suefro/openWM/README.md

# openWM
open-source programmer for washing machine
