suefro/openWM/PCB/WM_TriacSwitchModuleRev4.brd

## EAGLE design PCB/WM_TriacSwitchModuleRev4.brd (2017-04-11)

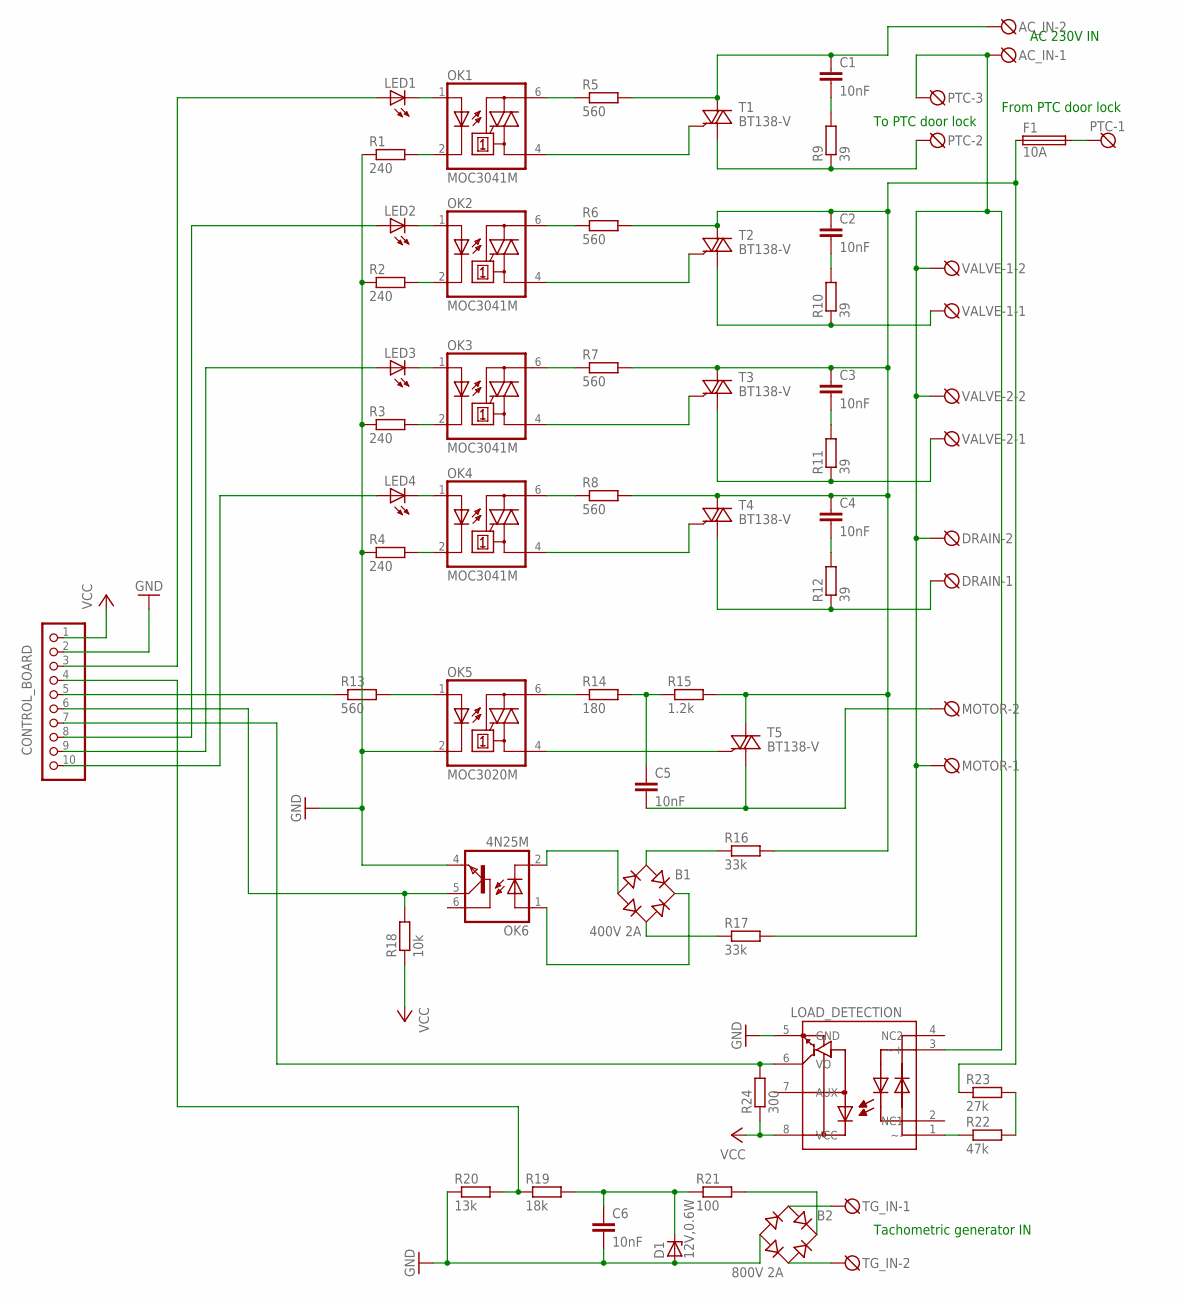
[picture p1: schematic WM_TriacSwitchModuleRev4.sch]

Parts:
AC_IN: N L; DG306-5.0-02P
B1: 400V 2A; RB1A
B2: 800V 2A; RB1A
C1, C2, C3, C4, C5: 10nF; C150-054X183
C6: 10nF; C050-024X044
CONTROL_BOARD: PINHD-1X10; 1X10-BIG
D1: 12V,0.6W; DO35Z10
DRAIN: L N; DG306-5.0-02P
F1: 10A; SH22,5
LED1, LED2, LED3, LED4: LEDCHIPLED_1206; CHIPLED_1206
LOAD_DETECTION: MID400; DIL08
MOTOR: N L; DG306-5.0-02P
OK1, OK2, OK3, OK4: MOC3041M; DIL06
OK5: MOC3020M; DIL06
OK6: 4N25M; DIL06
PTC: L_IN L_OUT N_OUT; DG306-5.0-03P
R1, R2, R3, R4: 240; 0207/10
R5, R6, R7, R8, R13: 560; 0207/10
R9, R10, R11, R12: 39; 0207/10
R14: 180; 0207/10
R15: 1.2k; 0207/10
R16, R17: 33k; 0207/10
R18: 10k; 0207/10
R19: 18k; 0207/10
R20: 13k; 0207/10
R21: 100; 0207/10
R22: 47k; 0207/15
R23: 27k; 0207/15
R24: 300; 0207/10
T1, T2, T3, T4, T5: BT138-V; TO220BV
TG_IN: DG3XX-02-5.0; DG306-5.0-02P
VALVE-1, VALVE-2: L N; DG306-5.0-02P

Connections:
GND: B2.-, C6.2, CONTROL_BOARD.2, D1.A, LOAD_DETECTION.5 (GND), OK5.2 (C), OK6.4 (EMI), R1.1, R2.1, R3.1, R4.1, R20.1
unnamed: LED1.C, OK1.1 (A)
unnamed: LED2.C, OK2.1 (A)
unnamed: LED3.C, OK3.1 (A)
unnamed: LED4.C, OK4.1 (A)
unnamed: OK1.2 (C), R1.2
unnamed: OK2.2 (C), R2.2
unnamed: OK3.2 (C), R3.2
unnamed: OK4.2 (C), R4.2
unnamed: AC_IN.1, DRAIN.2, LOAD_DETECTION.3 (~+), MOTOR.1, PTC.3, R17.2, VALVE-1.2, VALVE-2.2
unnamed: OK1.6 (A2), R5.1
unnamed: OK2.6 (A2), R6.1
unnamed: OK3.6 (A2), R7.1
unnamed: OK4.6 (A2), R8.1
unnamed: F1.2, PTC.1
unnamed: B1.-, OK6.2 (C)
unnamed: B1.AC1, R16.1
unnamed: OK3.4 (A1), T3.G
unnamed: OK4.4 (A1), T4.G
unnamed: OK2.4 (A1), T2.G
unnamed: OK1.4 (A1), T1.G
unnamed: PTC.2, R9.1, T1.T1 (A1)
unnamed: R10.1, T2.T1 (A1), VALVE-1.1
unnamed: R11.1, T3.T1 (A1), VALVE-2.1
unnamed: DRAIN.1, R12.1, T4.T1 (A1)
unnamed: C1.2, R9.2
unnamed: C2.2, R10.2
unnamed: C3.2, R11.2
unnamed: C4.2, R12.2
unnamed: OK5.1 (A), R13.2
unnamed: OK5.6 (A2), R14.1
unnamed: C5.1, R14.2, R15.1
unnamed: CONTROL_BOARD.6, OK6.5 (COL), R18.2
unnamed: OK5.4 (A1), T5.G
unnamed: B1.AC2, R17.1
unnamed: C2.1, C3.1, C4.1, F1.1, R6.2, R7.2, R8.2, R15.2, R16.2, R23.1, T2.T2 (A2), T3.T2 (A2), T4.T2 (A2), T5.T2 (A2)
unnamed: B2.AC1, TG_IN.1
unnamed: B1.+, OK6.1 (A)
unnamed: B2.AC2, TG_IN.2
unnamed: B2.+, R21.2
unnamed: C6.1, D1.C, R19.2, R21.1
unnamed: LOAD_DETECTION.1 (~-), R22.1
unnamed: AC_IN.2, C1.1, R5.2, T1.T2 (A2)
unnamed: R22.2, R23.2
unnamed: CONTROL_BOARD.3, LED1.A
unnamed: CONTROL_BOARD.7, LOAD_DETECTION.6 (VO), R24.2
unnamed: CONTROL_BOARD.4, R19.1, R20.2
unnamed: CONTROL_BOARD.5, R13.1
unnamed: CONTROL_BOARD.8, LED2.A
unnamed: CONTROL_BOARD.9, LED3.A
unnamed: CONTROL_BOARD.10, LED4.A
unnamed: C5.2, MOTOR.2, T5.T1 (A1)
VCC: CONTROL_BOARD.1, LOAD_DETECTION.8 (VCC), R18.1, R24.1

Notes on the sheet:
AC 230V IN
To PTC door lock
From PTC door lock
Tachometric generator IN

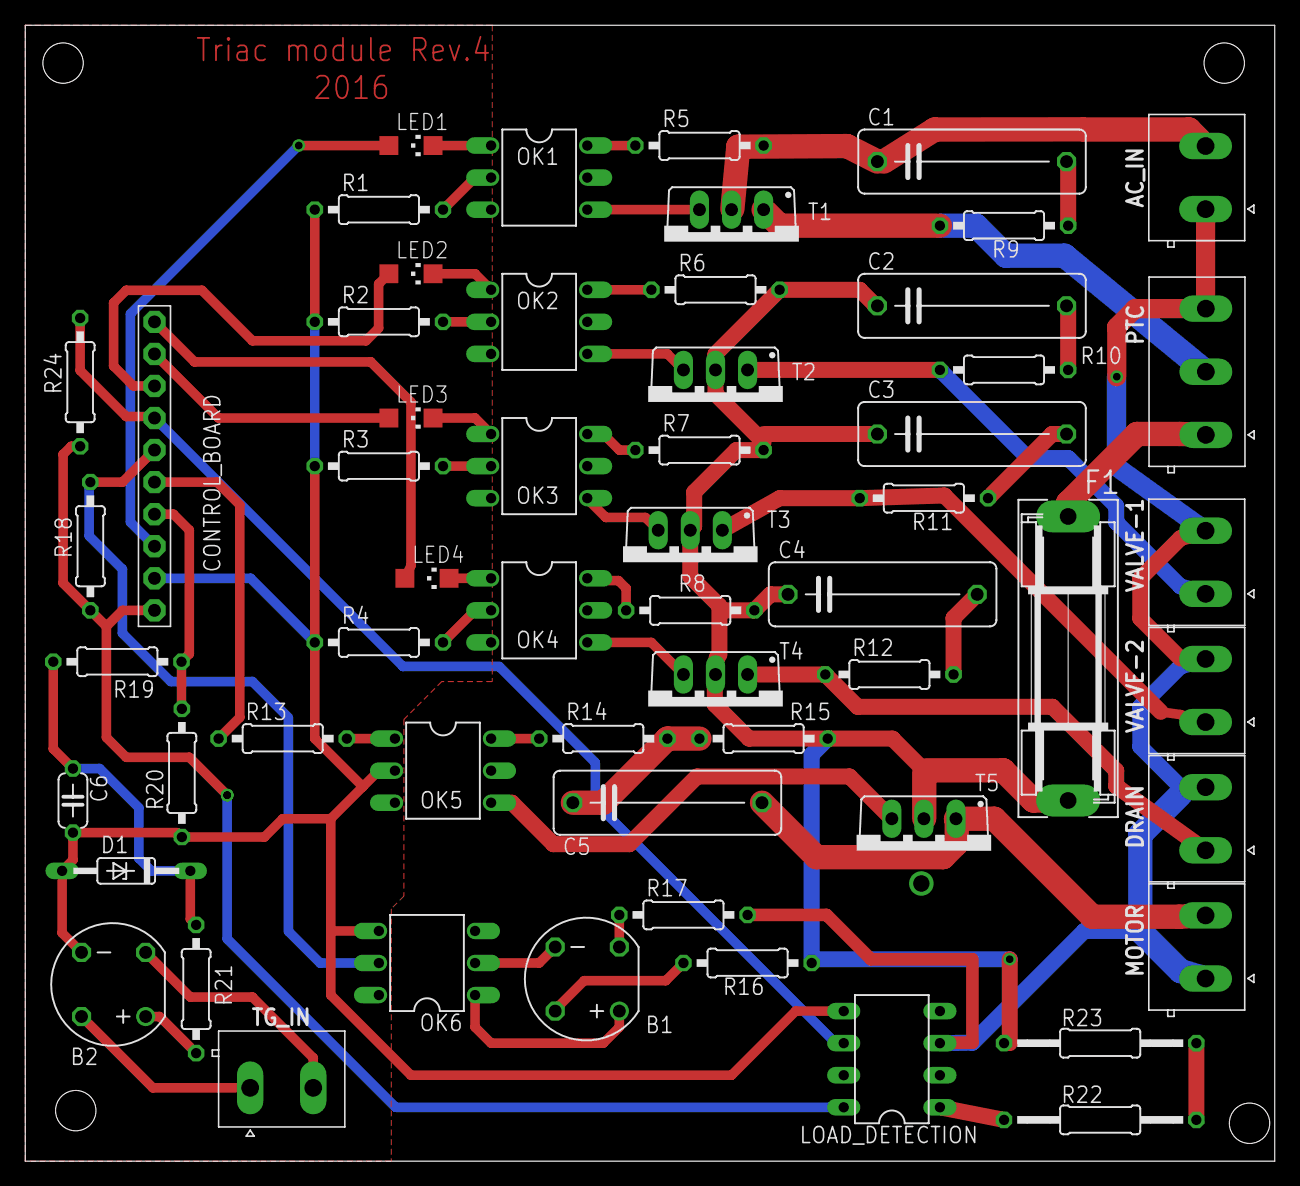
[picture p2: board WM_TriacSwitchModuleRev4.brd from above]

Board: 2 copper layers, 99.0 x 90.0 mm, 58 parts (0 on the bottom side), 53 nets.
