suefro/openWM/PCB/WM-main board1finalRev5_1.brd

## EAGLE design PCB/WM-main board1finalRev5_1.brd (2017-04-11)

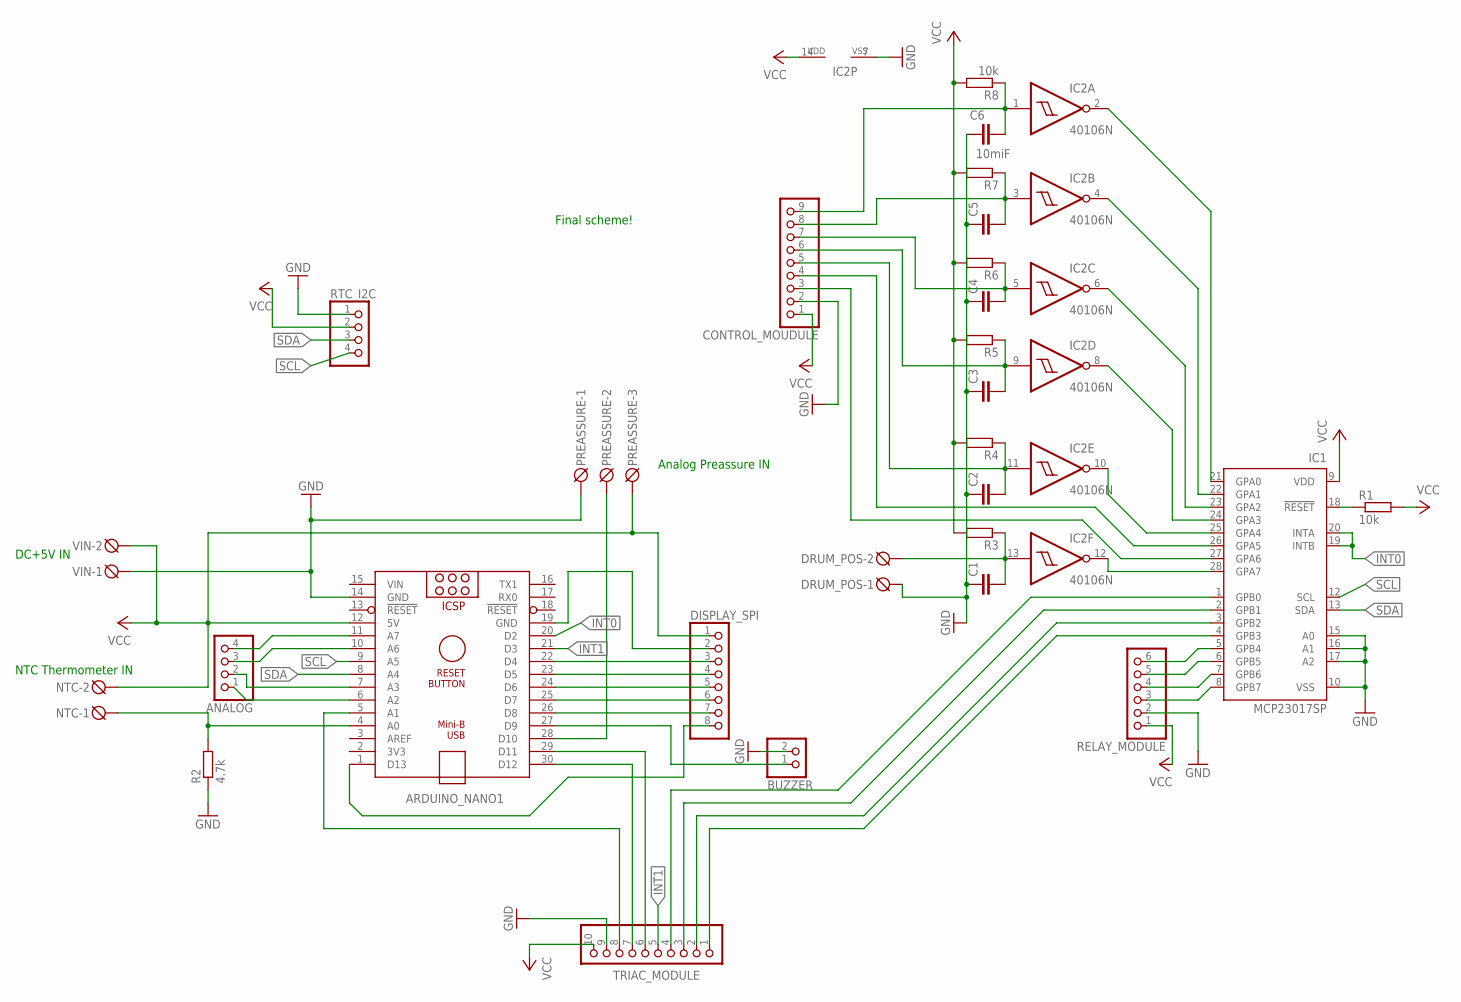
[picture p3: schematic WM-main board1finalRev5_1.sch]

Parts:
ANALOG: PINHD-1X4; 1X04
ARDUINO_NANO1: ARDUINO_NANO
BUZZER: PINHD-1X2; 1X02
C1, C2, C3, C4, C5: CC1206; C1206
C6: 10miF; C1206
CONTROL_MOUDULE: PINHD-1X9; 1X09-BIG
DISPLAY_SPI: PINHD-1X8BIG; 1X08-BIG
DRUM_POS: DRUM; DG306-5.0-02P
IC1: MCP23017SP; DIL28-3
IC2: 40106N; DIL14
NTC: TEMP; DG306-5.0-02P
PREASSURE: GND D10 +5V(out); DG306-5.0-03P
R1: 10k; 0204/7
R2: 4.7k; 0204/7
R3, R4, R5, R6, R7: R-EU_M1206; M1206
R8: 10k; M1206
RELAY_MODULE: PINHD-1X6B; 1X06-BIG
RTC_I2C: PINHD-1X4; 1X04
TRIAC_MODULE: PINHD-1X10; 1X10-BIG
VIN: GND +5V(IN); DG306-5.0-02P

Connections:
GND: ARDUINO_NANO1.14 (GND), BUZZER.2, C1.1, C2.1, C3.1, C4.1, C5.1, C6.1, CONTROL_MOUDULE.2, DRUM_POS.1, IC1.10 (VSS), IC1.15 (A0), IC1.16 (A1), IC1.17 (A2), IC2.7 (VSS), PREASSURE.1, R2.1, RELAY_MODULE.2, RTC_I2C.1, TRIAC_MODULE.9, VIN.1
INT0: ARDUINO_NANO1.20 (D2), IC1.19 (INTB), IC1.20 (INTA)
INT1: ARDUINO_NANO1.21 (D3), TRIAC_MODULE.5
unnamed: IC1.18 (!RESET), R1.1
unnamed: ARDUINO_NANO1.4 (A0), NTC.1, R2.2
unnamed: IC1.21 (GPA0), IC2.2 (O)
unnamed: IC1.22 (GPA1), IC2.4 (O)
unnamed: ARDUINO_NANO1.28 (D10), PREASSURE.2
unnamed: IC1.23 (GPA2), IC2.6 (O)
unnamed: IC1.24 (GPA3), IC2.8 (O)
unnamed: IC1.25 (GPA4), IC2.10 (O)
unnamed: IC1.28 (GPA7), IC2.12 (O)
unnamed: C1.2, DRUM_POS.2, IC2.13 (I), R3.1
unnamed: C2.2, CONTROL_MOUDULE.5, IC2.11 (I), R4.1
unnamed: C3.2, CONTROL_MOUDULE.6, IC2.9 (I), R5.1
unnamed: C4.2, CONTROL_MOUDULE.7, IC2.5 (I), R6.1
unnamed: C5.2, CONTROL_MOUDULE.8, IC2.3 (I), R7.1
unnamed: C6.2, CONTROL_MOUDULE.9, IC2.1 (I), R8.1
unnamed: ANALOG.1, ARDUINO_NANO1.6 (A2)
unnamed: ARDUINO_NANO1.27 (D9), BUZZER.1
unnamed: ARDUINO_NANO1.26 (D8), DISPLAY_SPI.7
unnamed: ARDUINO_NANO1.25 (D7), DISPLAY_SPI.6
unnamed: ARDUINO_NANO1.24 (D6), DISPLAY_SPI.5
unnamed: ARDUINO_NANO1.23 (D5), DISPLAY_SPI.4
unnamed: CONTROL_MOUDULE.4, IC1.26 (GPA5)
unnamed: ARDUINO_NANO1.22 (D4), DISPLAY_SPI.3
unnamed: ARDUINO_NANO1.19 (GND), DISPLAY_SPI.2
unnamed: CONTROL_MOUDULE.3, IC1.27 (GPA6)
unnamed: IC1.6 (GPB5), RELAY_MODULE.5
unnamed: ARDUINO_NANO1.29 (D11), TRIAC_MODULE.6
unnamed: IC1.7 (GPB6), RELAY_MODULE.4
unnamed: IC1.8 (GPB7), RELAY_MODULE.3
unnamed: ANALOG.2, ARDUINO_NANO1.7 (A3)
unnamed: IC1.4 (GPB3), TRIAC_MODULE.1
unnamed: IC1.1 (GPB0), TRIAC_MODULE.4
unnamed: IC1.2 (GPB1), TRIAC_MODULE.3
unnamed: IC1.3 (GPB2), TRIAC_MODULE.2
unnamed: ARDUINO_NANO1.30 (D12), TRIAC_MODULE.7
unnamed: ANALOG.3, ARDUINO_NANO1.10 (A6)
unnamed: ANALOG.4, ARDUINO_NANO1.11 (A7)
unnamed: IC1.5 (GPB4), RELAY_MODULE.6
unnamed: ARDUINO_NANO1.1 (D13), DISPLAY_SPI.8
unnamed: ARDUINO_NANO1.5 (A1), TRIAC_MODULE.8
SCL: ARDUINO_NANO1.9 (A5), IC1.12 (SCL), RTC_I2C.4
SDA: ARDUINO_NANO1.8 (A4), IC1.13 (SDA), RTC_I2C.3
VCC: ARDUINO_NANO1.12 (5V), CONTROL_MOUDULE.1, DISPLAY_SPI.1, IC1.9 (VDD), IC2.14 (VDD), NTC.2, PREASSURE.3, R1.2, R3.2, R4.2, R5.2, R6.2, R7.2, R8.2, RELAY_MODULE.1, RTC_I2C.2, TRIAC_MODULE.10, VIN.2
VIN: ARDUINO_NANO1.15 (VIN)

Notes on the sheet:
Final scheme!
DC+5V IN
NTC Thermometer IN
Analog Preassure IN

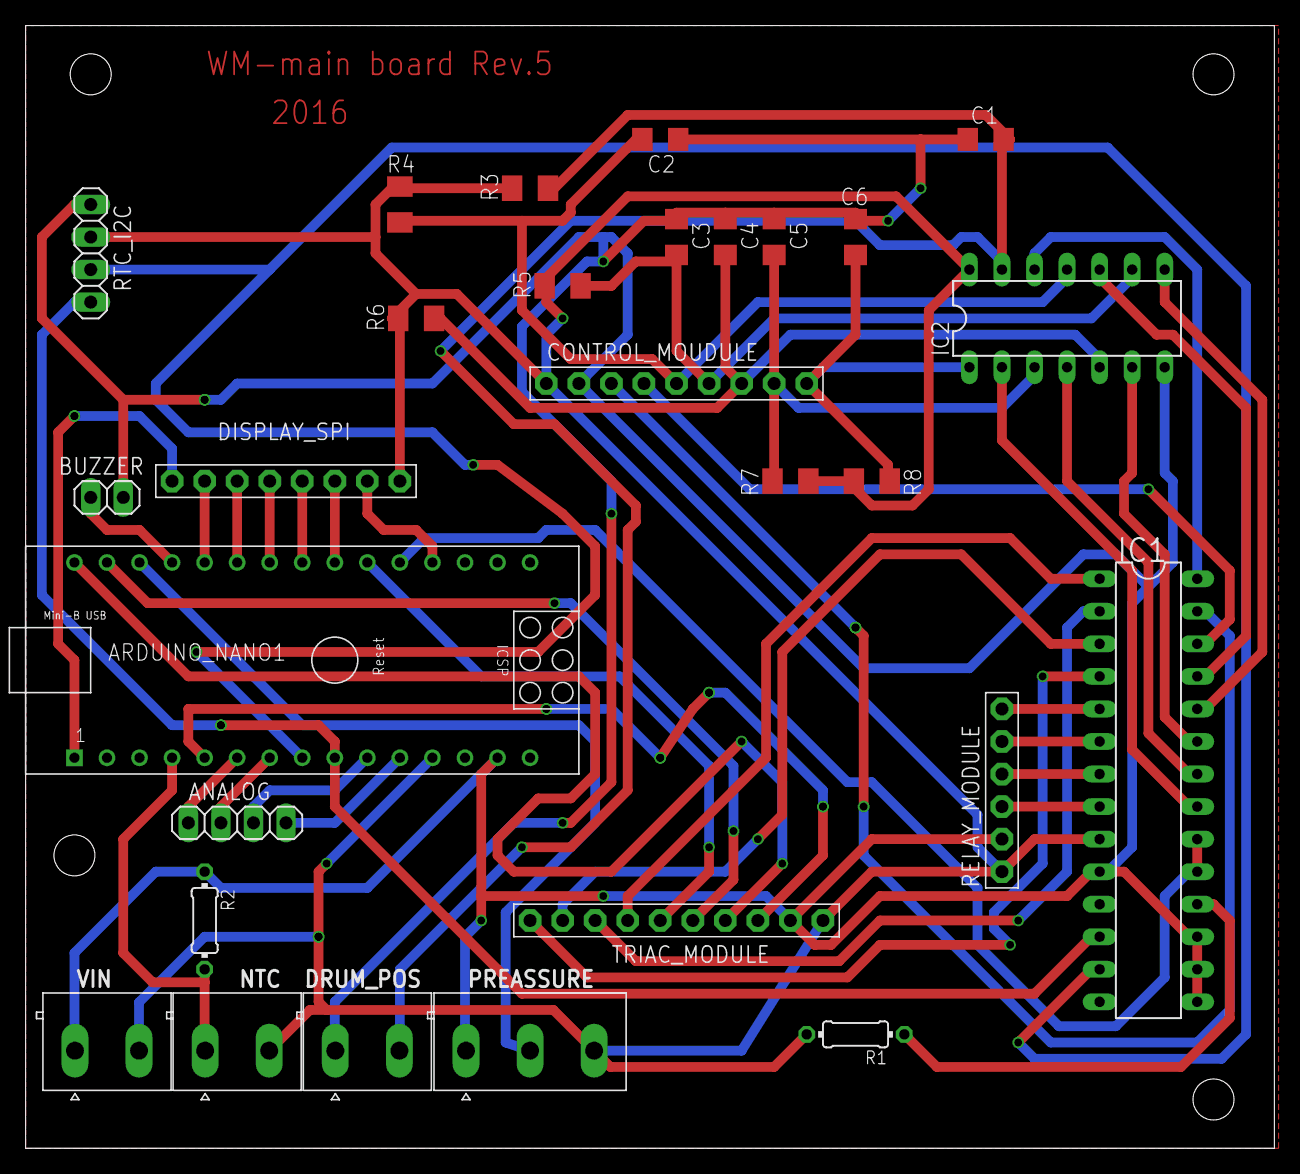
[picture p4: board WM-main board1finalRev5_1.brd from above]

Board: 2 copper layers, 97.5 x 87.6 mm, 28 parts (0 on the bottom side), 46 nets.
