suefro/openWM/PCB/WM-control_module_Rev1.brd

## EAGLE design PCB/WM-control_module_Rev1.brd (2017-04-11)

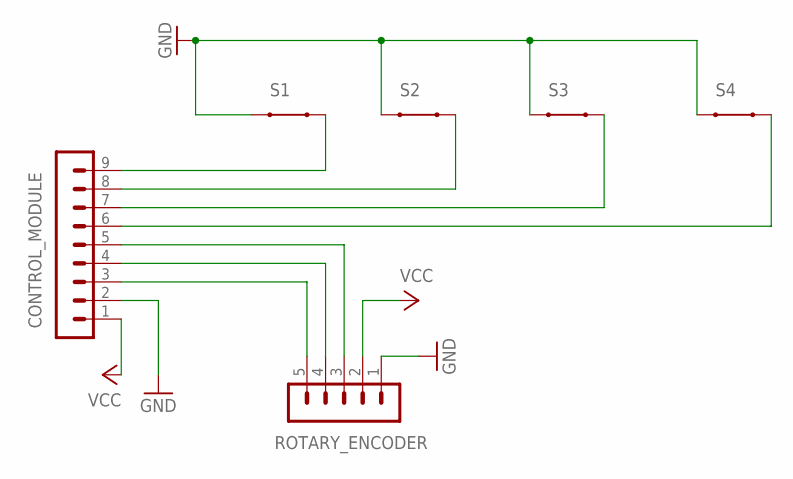
[picture p5: schematic WM-control_module_Rev1.sch]

Parts:
CONTROL_MODULE: MA09-1
ROTARY_ENCODER: MA05-1
S1, S2, S3, S4: SWITCH-MOMENTARY-2-CLOSED; TACTILE-PTH-12MM

Connections:
GND: CONTROL_MODULE.2, ROTARY_ENCODER.1, S1.1, S2.1, S3.1, S4.1
unnamed: CONTROL_MODULE.3, ROTARY_ENCODER.5
unnamed: CONTROL_MODULE.4, ROTARY_ENCODER.4
unnamed: CONTROL_MODULE.5, ROTARY_ENCODER.3
unnamed: CONTROL_MODULE.9, S1.3 (2)
unnamed: CONTROL_MODULE.8, S2.3 (2)
unnamed: CONTROL_MODULE.7, S3.3 (2)
unnamed: CONTROL_MODULE.6, S4.3 (2)
VCC: CONTROL_MODULE.1, ROTARY_ENCODER.2

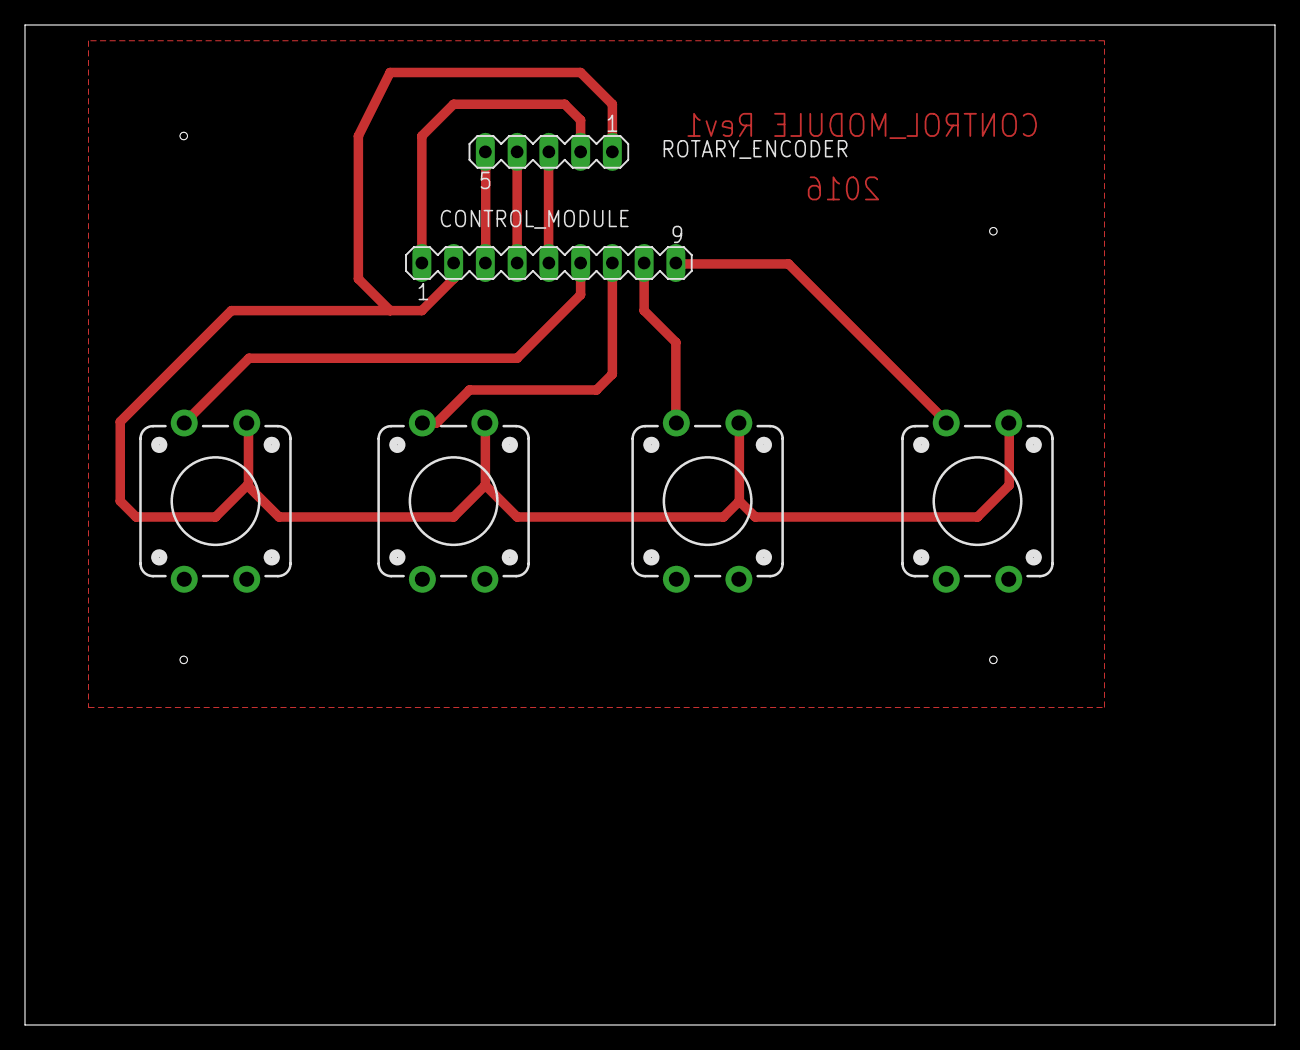
[picture p6: board WM-control_module_Rev1.brd from above]

Board: 2 copper layers, 100.0 x 80.0 mm, 6 parts (0 on the bottom side), 9 nets.
