suefro/openWM/(commit log)

2016-07-10 adding new functions
    add reverse motor function (not tested on hardware yet)
    change rotary encoder pins behavior on interrupt CHANGE
    [openWM_testprog.ino, testsforWM.ino]
2016-07-12 New functions
    better start rotate motor (too long then start)
    [openWM_testprog.ino, testsforWM.ino]
2016-07-19 new functions
    add function spin_motor
    some corrects in drum_unload
    testing with real load
    changes some constants in speedcontrol
    function washing_motor has a new parameter
    [openWM_testprog.ino]
2016-11-28 Small changes for rev5 board
    change set display pins
2016-11-28 New rev5 board
    - create library for sensors
    -need change display library
    -need create dignostic library, washing programs library, motor lib, control lib?
2016-11-28 changes pins
    change pins variable type from int to uint8
    fix baclight pin
    [openWM_Rev5.ino]
2016-12-09 Change hardware pins
    drain pump, valve1, valve2, power load detection
2016-12-17 Fix speedcontrol library
    check if this fix work
    [SensorsWM.cpp, SensorsWM.h, openWM_Rev5.ino]
2017-04-11 Merge functions
    -merge some functions
    -better speedcontrol
    -need edit drum_position function (not working)
    -still need better diagnostic
    [SensorsWM.cpp, SensorsWM.h, openWM_Rev5.ino]
2017-04-11 Add Eagle diagrams
    -add control module
    -add main board module
    -add triac switch module
    [WM-control_module_Rev1.brd, WM-control_module_Rev1.sch, WM-main board1finalRev5_1.brd, WM-main board1finalRev5_1.sch, WM_TriacSwitchModuleRev4.brd, WM_TriacSwitchModuleRev4.sch]
2018-03-27 Remove control buttons
    Remove 4 control buttons
    -WM will be controlled only by rotary encoder and one button
